VasuAgrawal/BedPresence/PCB/main_board/main_board.kicad_pcb

## KiCad design PCB/main_board/main_board.kicad_pcb (2021-10-16)

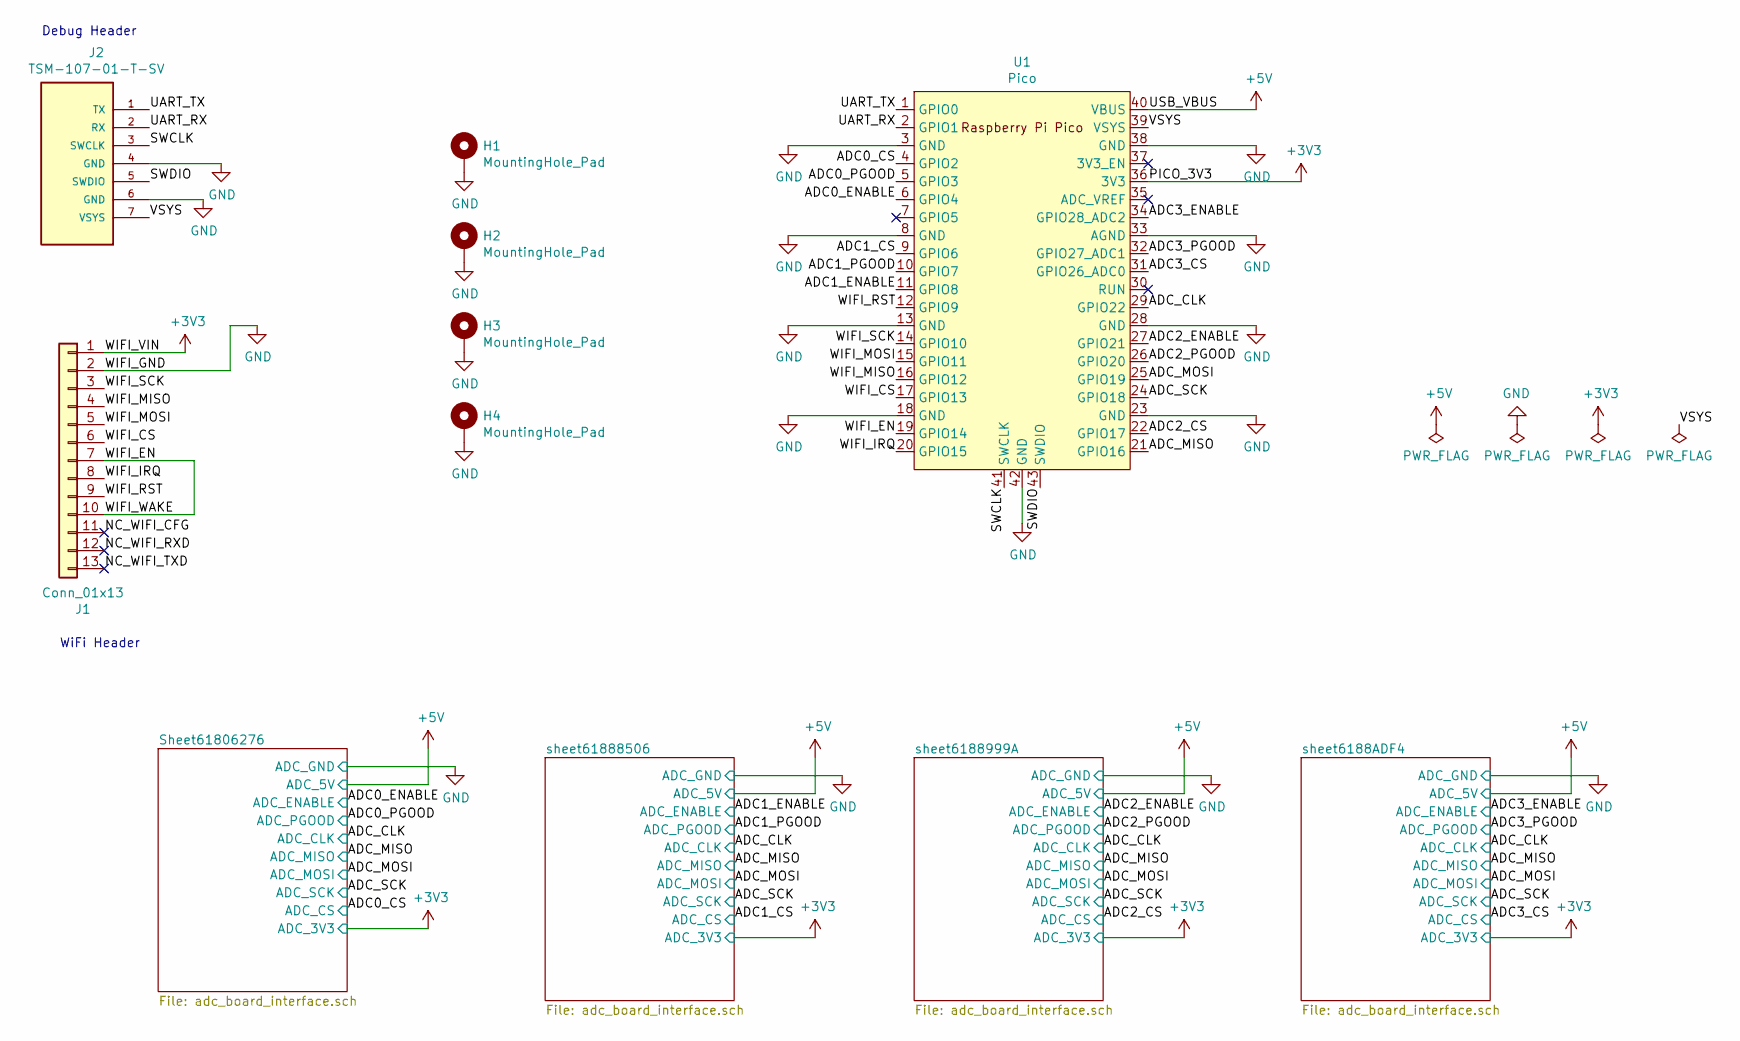
[picture p1: schematic main_board.sch]

Parts:
H1, H2, H3, H4: MountingHole_Pad; MountingHole_3.2mm_M3_Pad_Via
J1: Conn_01x13; PinHeader_1x13_P2.54mm_Vertical_SMD_Pin1Left_with_holes
J2: TSM-107-01-T-SV; SAMTEC_TSM-107-01-T-SV
U1: Pico; RPi_Pico_SMD

Connections:
+3V3: J1.1, U1.36 (3V3); also elsewhere on the board
+5V: U1.40 (VBUS); also elsewhere on the board
/ADC0_CS: U1.4 (GPIO2); also elsewhere on the board
/ADC0_ENABLE: U1.6 (GPIO4); also elsewhere on the board
/ADC0_PGOOD: U1.5 (GPIO3); also elsewhere on the board
/ADC1_CS: U1.9 (GPIO6); also elsewhere on the board
/ADC1_ENABLE: U1.11 (GPIO8); also elsewhere on the board
/ADC1_PGOOD: U1.10 (GPIO7); also elsewhere on the board
/ADC2_CS: U1.22 (GPIO17); also elsewhere on the board
/ADC2_ENABLE: U1.27 (GPIO21); also elsewhere on the board
/ADC2_PGOOD: U1.26 (GPIO20); also elsewhere on the board
/ADC3_CS: U1.31 (GPIO26_ADC0); also elsewhere on the board
/ADC3_ENABLE: U1.34 (GPIO28_ADC2); also elsewhere on the board
/ADC3_PGOOD: U1.32 (GPIO27_ADC1); also elsewhere on the board
/ADC_CLK: U1.29 (GPIO22); also elsewhere on the board
/ADC_MISO: U1.21 (GPIO16); also elsewhere on the board
/ADC_MOSI: U1.25 (GPIO19); also elsewhere on the board
/ADC_SCK: U1.24 (GPIO18); also elsewhere on the board
/NC_WIFI_CFG: J1.11
/NC_WIFI_RXD: J1.12
/NC_WIFI_TXD: J1.13
/SWCLK: J2.3 (SWCLK), U1.41 (SWCLK)
/SWDIO: J2.5 (SWDIO), U1.43 (SWDIO)
/UART_RX: J2.2 (RX), U1.2 (GPIO1)
/UART_TX: J2.1 (TX), U1.1 (GPIO0)
/VSYS: J2.7 (VSYS), U1.39 (VSYS)
/WIFI_CS: J1.6, U1.17 (GPIO13)
/WIFI_EN: J1.7, J1.10, U1.19 (GPIO14)
/WIFI_IRQ: J1.8, U1.20 (GPIO15)
/WIFI_MISO: J1.4, U1.16 (GPIO12)
/WIFI_MOSI: J1.5, U1.15 (GPIO11)
/WIFI_RST: J1.9, U1.12 (GPIO9)
/WIFI_SCK: J1.3, U1.14 (GPIO10)
GND: H1.1, H2.1, H3.1, H4.1, J1.2, J2.4 (GND), J2.6 (GND), U1.3 (GND), U1.8 (GND), U1.13 (GND), U1.18 (GND), U1.23 (GND), U1.28 (GND), U1.33 (AGND), U1.38 (GND), U1.42 (GND); also elsewhere on the board

Notes on the sheet:
WiFi Header
Debug Header

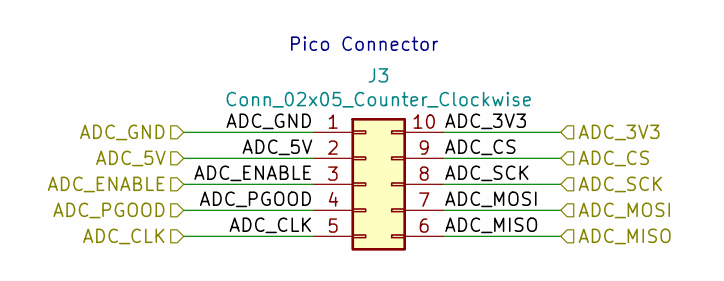
[picture p2: schematic adc_board_interface.sch]

Parts:
J3: Conn_02x05_Counter_Clockwise; PinHeader_2x05_P2.54mm_Vertical_SMD

Connections:
+3V3: J3.10; also elsewhere on the board
+5V: J3.2; also elsewhere on the board
/ADC0_CS: J3.9; also elsewhere on the board
/ADC0_ENABLE: J3.3; also elsewhere on the board
/ADC0_PGOOD: J3.4; also elsewhere on the board
/ADC_CLK: J3.5; also elsewhere on the board
/ADC_MISO: J3.6; also elsewhere on the board
/ADC_MOSI: J3.7; also elsewhere on the board
/ADC_SCK: J3.8; also elsewhere on the board
GND: J3.1; also elsewhere on the board

Parts of its further copies:
J4, J5, J6: Conn_02x05_Counter_Clockwise; PinHeader_2x05_P2.54mm_Vertical_SMD

Connections of its further copies:
+3V3: J4.10, J5.10, J6.10; also elsewhere on the board
+5V: J4.2, J5.2, J6.2; also elsewhere on the board
/ADC1_CS: J4.9; also elsewhere on the board
/ADC1_ENABLE: J4.3; also elsewhere on the board
/ADC1_PGOOD: J4.4; also elsewhere on the board
/ADC2_CS: J5.9; also elsewhere on the board
/ADC2_ENABLE: J5.3; also elsewhere on the board
/ADC2_PGOOD: J5.4; also elsewhere on the board
/ADC3_CS: J6.9; also elsewhere on the board
/ADC3_ENABLE: J6.3; also elsewhere on the board
/ADC3_PGOOD: J6.4; also elsewhere on the board
/ADC_CLK: J4.5, J5.5, J6.5; also elsewhere on the board
/ADC_MISO: J4.6, J5.6, J6.6; also elsewhere on the board
/ADC_MOSI: J4.7, J5.7, J6.7; also elsewhere on the board
/ADC_SCK: J4.8, J5.8, J6.8; also elsewhere on the board
GND: J4.1, J5.1, J6.1; also elsewhere on the board

Notes on the sheet:
Pico Connector

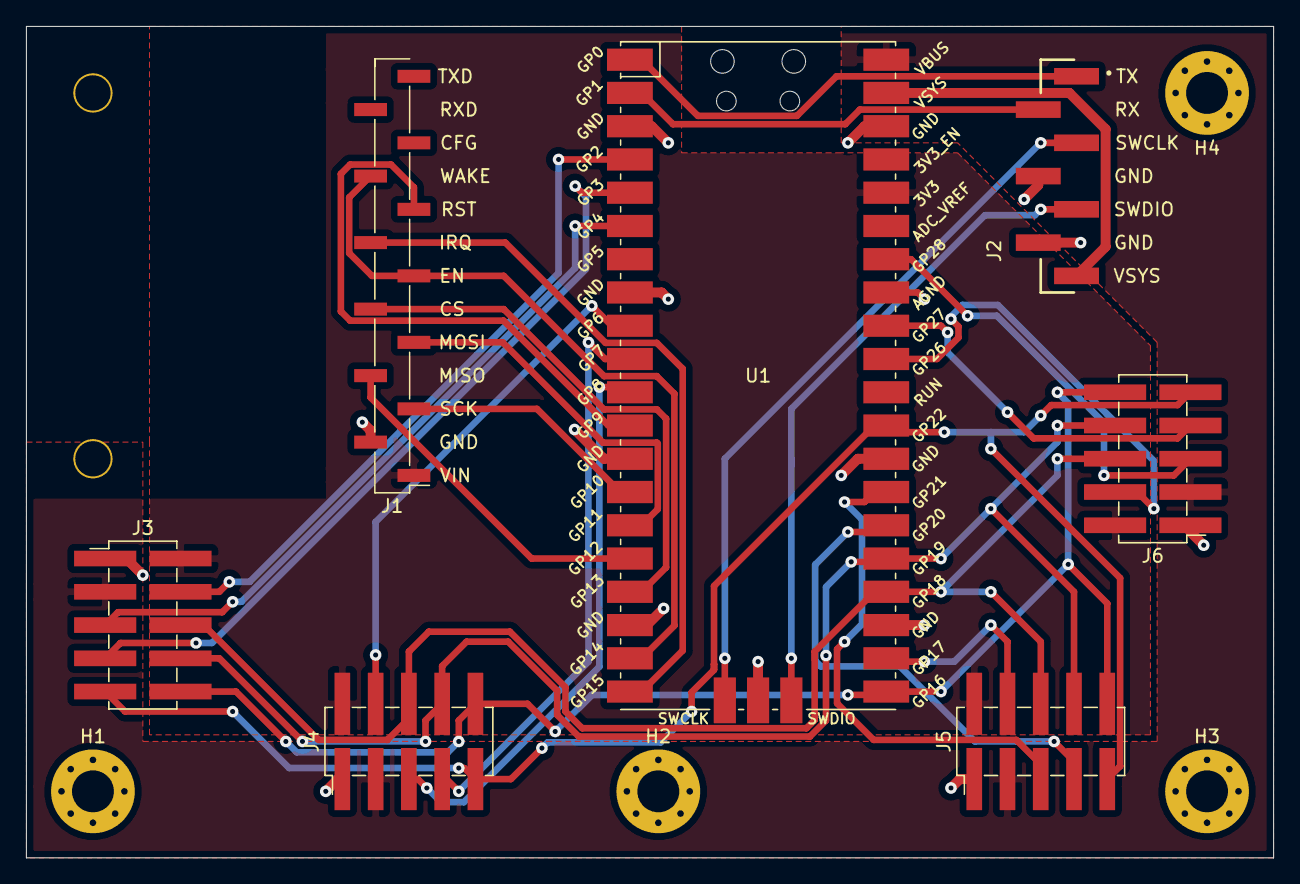
[picture p3: board main_board.kicad_pcb from above]

Board: 2 copper layers, 95.2 x 63.5 mm, 11 parts (0 on the bottom side), 31 nets.
