VasuAgrawal/BedPresence/PCB/pico_probe/pico_probe.kicad_pcb

## KiCad design PCB/pico_probe/pico_probe.kicad_pcb (2021-10-11)

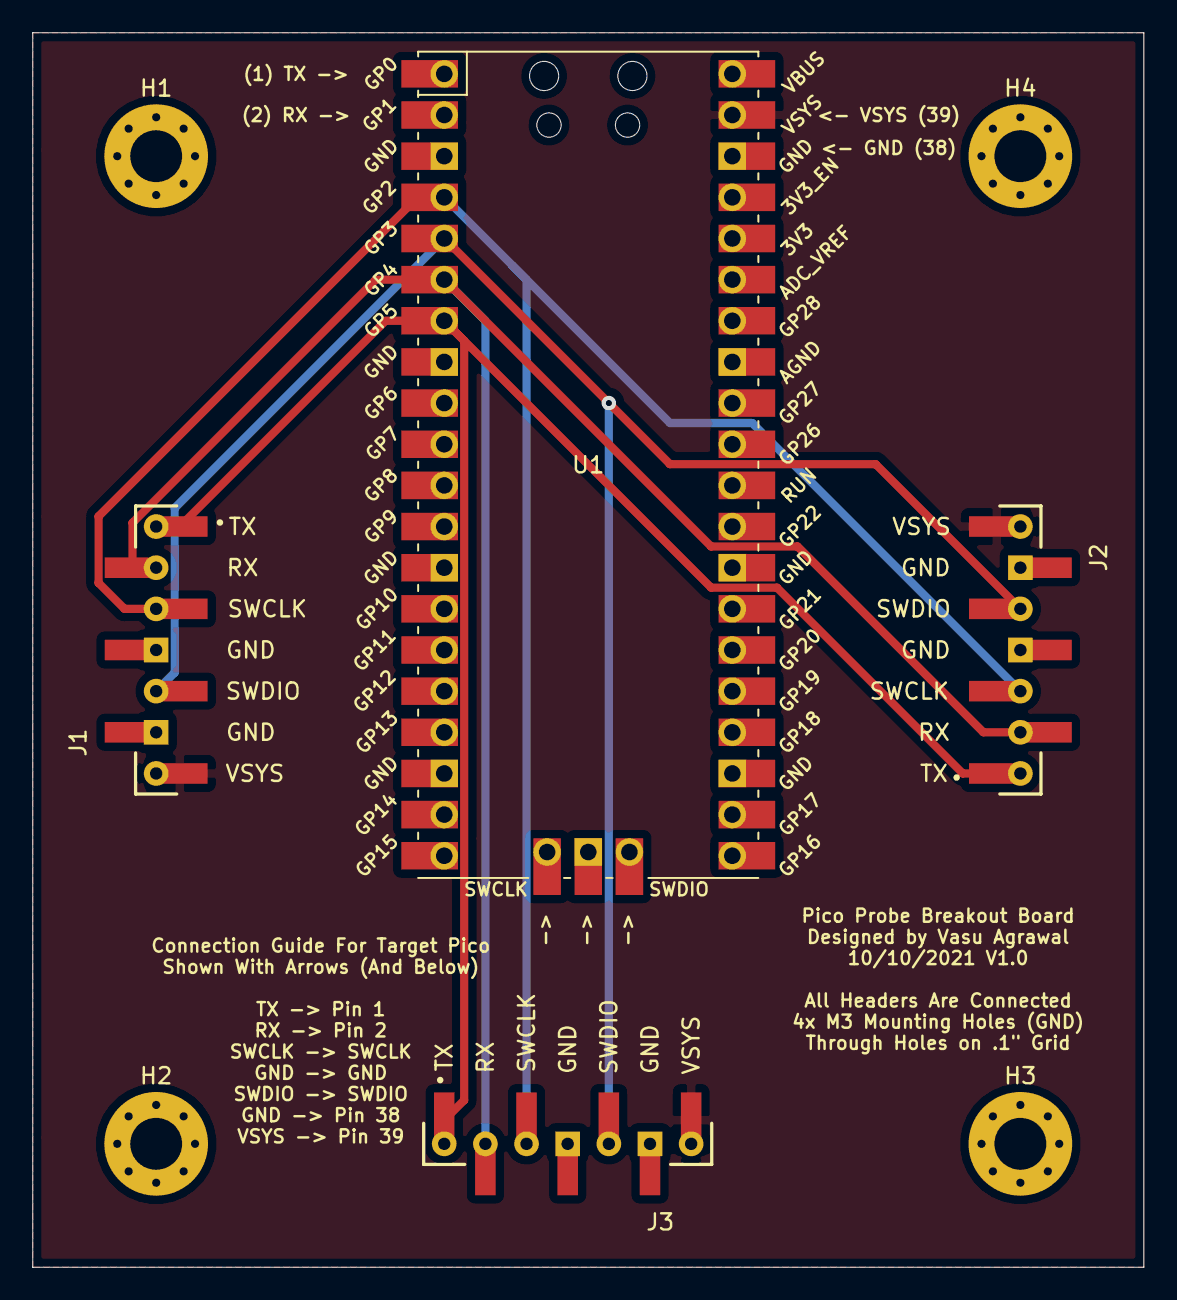
[picture p4: board pico_probe.kicad_pcb from above]

Board: 2 copper layers, 68.6 x 76.2 mm, 8 parts (0 on the bottom side), 6 nets.

Parts:
H1, H2, H3, H4: MountingHole_Pad; MountingHole_3.2mm_M3_Pad_Via
J1, J2, J3: TSM-107-01-T-SV; SAMTEC_TSM-107-01-T-SV_THRU
U1: Pico; RPi_Pico_SMD_TH

Connections:
/PROBE_UART1_RX: J1.1, J2.1, J3.1, U1.7
/PROBE_UART1_TX: J1.2, J2.2, J3.2, U1.6
/SWCLK: J1.3, J2.3, J3.3, U1.4
/SWDIO: J1.5, J2.5, J3.5, U1.5
/VSYS: J1.7, J2.7, J3.7, U1.39
GND: H1.1, H2.1, H3.1, H4.1, J1.4, J1.6, J2.4, J2.6, J3.4, J3.6, U1.3, U1.8, U1.13, U1.18, U1.23, U1.28, U1.33, U1.38, U1.42
