VasuAgrawal/BedPresence/PCB/adc_board/adc_board.kicad_pcb

## KiCad design PCB/adc_board/adc_board.kicad_pcb (2021-10-10)

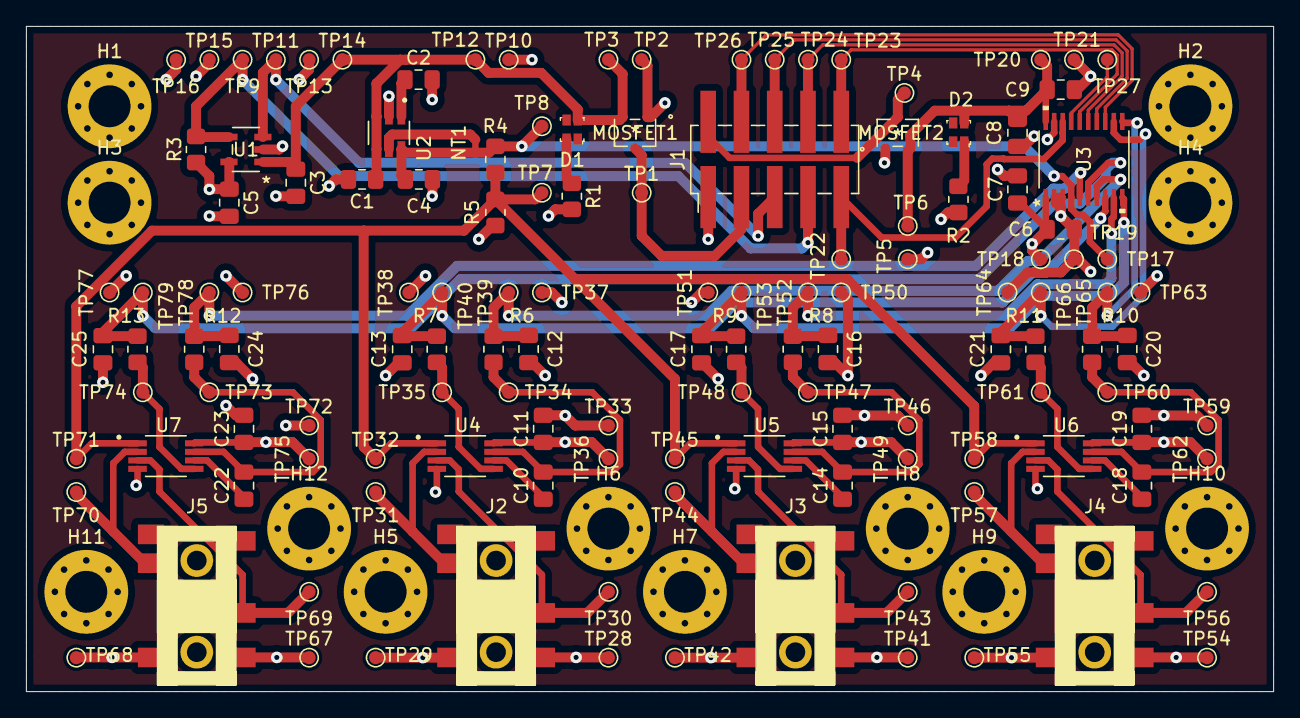
[picture p5: board adc_board.kicad_pcb from above]

Board: 4 copper layers, 95.2 x 50.8 mm, 146 parts (0 on the bottom side), 48 nets.

Parts:
C1, C2, C4, C6, C9, C11, C12, C13, C15, C16, C17, C19, C20, C21, C23, C24, C25: 0.1uF; C_0805_2012Metric_Pad1.18x1.45mm_HandSolder
C3, C5, C7, C8: 10uF; C_0805_2012Metric_Pad1.18x1.45mm_HandSolder
C10, C14, C18, C22: 10nF; C_0805_2012Metric_Pad1.18x1.45mm_HandSolder
D1, D2: LTST-C19HE1WT; LED_Dual0603
H1, H2, H3, H4, H5, H6, H7, H8, H9, H10, H11, H12: MountingHole; MountingHole_3.2mm_M3_Pad_Via
J1: Conn_02x05_Counter_Clockwise; PinHeader_2x05_P2.54mm_Vertical_SMD
J2, J3, J4, J5: 54-00177
MOSFET1, MOSFET2: SSM3J332R
NT1: Net-Tie_2; NetTie-2_SMD_Pad0.5mm
R1, R2, R6, R7, R8, R9, R10, R11, R12, R13: 100R; R_0805_2012Metric_Pad1.20x1.40mm_HandSolder
R3, R4, R5: 10K 0.5%; R_0805_2012Metric_Pad1.20x1.40mm_HandSolder
TP1, TP4: 3V3; TestPoint_Pad_D1.0mm
TP2, TP5, TP10, TP13, TP16, TP19, TP21, TP29, TP33, TP37, TP38, TP42, TP46, TP50, TP51, TP55, TP59, TP63, TP64, TP68, TP72, TP76, TP77: GND; TestPoint_Pad_D1.0mm
TP3, TP12, TP14: 5V_PROT; TestPoint_Pad_D1.0mm
TP6: 3V3_PROT; TestPoint_Pad_D1.0mm
TP7: 1V65_REF; TestPoint_Pad_D1.0mm
TP8, TP17: 3V3_REF; TestPoint_Pad_D1.0mm
TP9: PGOOD; TestPoint_Pad_D1.0mm
TP11: ENABLE; TestPoint_Pad_D1.0mm
TP15, TP18: AVDD; TestPoint_Pad_D1.0mm
TP20: DVDD; TestPoint_Pad_D1.0mm
TP22: CLK; TestPoint_Pad_D1.0mm
TP23: MISO; TestPoint_Pad_D1.0mm
TP24: MOSI; TestPoint_Pad_D1.0mm
TP25: SCK; TestPoint_Pad_D1.0mm
TP26: CS; TestPoint_Pad_D1.0mm
TP27: IRQ; TestPoint_Pad_D1.0mm
TP28, TP36, TP41, TP49, TP54, TP62, TP67, TP75: VDD; TestPoint_Pad_D1.0mm
TP30, TP43, TP56, TP69: BR+; TestPoint_Pad_D1.0mm
TP31, TP44, TP57, TP70: BR-; TestPoint_Pad_D1.0mm
TP32, TP45, TP58, TP71: 1V65; TestPoint_Pad_D1.0mm
TP34, TP47, TP60, TP73: AMP+; TestPoint_Pad_D1.0mm
TP35, TP48, TP61, TP74: AMP-; TestPoint_Pad_D1.0mm
TP39, TP52, TP65, TP78: DIFF+; TestPoint_Pad_D1.0mm
TP40, TP53, TP66, TP79: DIFF-; TestPoint_Pad_D1.0mm
U1: MCP1755T-3302E_OT; MCP1755T-3302E&slash_OT
U2: MAX6070BAUT33T; SOT95P280X145-6N
U3: MCP3564-E_ST; MCP3564-E&slash_ST
U4, U5, U6, U7: MAX4209HAUA; SOP65P490X110-8N

Connections:
+3V3: J1.10, MOSFET2.3, TP4.1
+5V: J1.2, MOSFET1.3, TP1.1
/1V65_REF: R4.2, R5.1, TP7.1, TP32.1, TP45.1, TP58.1, TP71.1, U4.1, U5.1, U6.1, U7.1
/3V3_PROT: C8.1, C9.1, D2.4, MOSFET2.2, TP6.1, TP20.1, U3.20
/3V3_REF_FILTER: C2.1, U2.1
/3V3_REF_OUT: C4.1, NT1.2, R4.1, TP8.1, TP17.1, U2.6, U3.4
/3V3_REF_OUTS: NT1.1, U2.5
/3V3_REF_VIN: C1.1, C3.1, D1.4, MOSFET1.2, TP3.1, TP12.1, TP14.1, U1.1, U2.3, U2.4
/ADC_AVDD: C5.1, C6.1, C7.1, C11.1, C15.1, C19.1, C23.1, J2.1, J3.1, J4.1, J5.1, R3.1, TP15.1, TP18.1, TP28.1, TP36.1, TP41.1, TP49.1, TP54.1, TP62.1, TP67.1, TP75.1, U1.5, U3.1, U4.8, U5.8, U6.8, U7.8
/ADC_CLK: J1.5, TP22.1, U3.18
/ADC_IRQ: TP27.1, U3.17
/CS: J1.9, TP26.1, U3.13
/ENABLE: J1.3, TP11.1, U1.3
/MISO: J1.6, TP23.1, U3.16
/MOSI: J1.7, TP24.1, U3.15
/PGOOD: J1.4, R3.2, TP9.1, U1.4
/SCK: J1.8, TP25.1, U3.14
/Sheet61550FD4/ADC_CH0: C24.1, R12.2, TP78.1, U3.5
/Sheet61550FD4/ADC_CH1: C25.1, R13.2, TP79.1, U3.6
/Sheet61550FD4/ADC_CH2: C12.1, R6.2, TP39.1, U3.7
/Sheet61550FD4/ADC_CH3: C13.1, R7.2, TP40.1, U3.8
/Sheet61550FD4/ADC_CH4: C16.1, R8.2, TP52.1, U3.9
/Sheet61550FD4/ADC_CH5: C17.1, R9.2, TP53.1, U3.10
/Sheet61550FD4/ADC_CH6: C20.1, R10.2, TP65.1, U3.11
/Sheet61550FD4/ADC_CH7: C21.1, R11.2, TP66.1, U3.12
/Sheet61550FD4/Bridge0/BRIDGE+: J5.3, TP69.1, U7.3
/Sheet61550FD4/Bridge0/BRIDGE-: J5.4, TP70.1, U7.2
/Sheet61550FD4/Bridge0/INST_AMP+: C22.1, R12.1, TP73.1, U7.7
/Sheet61550FD4/Bridge0/INST_AMP-: R13.1, TP74.1, U7.5
/Sheet61550FD4/Bridge1/BRIDGE+: J2.3, TP30.1, U4.3
/Sheet61550FD4/Bridge1/BRIDGE-: J2.4, TP31.1, U4.2
/Sheet61550FD4/Bridge1/INST_AMP+: C10.1, R6.1, TP34.1, U4.7
/Sheet61550FD4/Bridge1/INST_AMP-: R7.1, TP35.1, U4.5
/Sheet61550FD4/Bridge2/BRIDGE+: J3.3, TP43.1, U5.3
/Sheet61550FD4/Bridge2/BRIDGE-: J3.4, TP44.1, U5.2
/Sheet61550FD4/Bridge2/INST_AMP+: C14.1, R8.1, TP47.1, U5.7
/Sheet61550FD4/Bridge2/INST_AMP-: R9.1, TP48.1, U5.5
/Sheet61550FD4/Bridge3/BRIDGE+: J4.3, TP56.1, U6.3
/Sheet61550FD4/Bridge3/BRIDGE-: J4.4, TP57.1, U6.2
/Sheet61550FD4/Bridge3/INST_AMP+: C18.1, R10.1, TP60.1, U6.7
/Sheet61550FD4/Bridge3/INST_AMP-: R11.1, TP61.1, U6.5
GND: C1.2, C2.2, C3.2, C4.2, C5.2, C6.2, C7.2, C8.2, C9.2, C11.2, C12.2, C13.2, C15.2, C16.2, C17.2, C19.2, C20.2, C21.2, C23.2, C24.2, C25.2, H1.1, H2.1, H3.1, H4.1, H5.1, H6.1, H7.1, H8.1, H9.1, H10.1, H11.1, H12.1, J1.1, J2.2, J3.2, J4.2, J5.2, MOSFET1.1, MOSFET2.1, R1.2, R2.2, R5.2, TP2.1, TP5.1, TP10.1, TP13.1, TP16.1, TP19.1, TP21.1, TP29.1, TP33.1, TP37.1, TP38.1, TP42.1, TP46.1, TP50.1, TP51.1, TP55.1, TP59.1, TP63.1, TP64.1, TP68.1, TP72.1, TP76.1, TP77.1, U1.2, U2.2, U3.2, U3.3, U3.19, U4.4, U5.4, U6.4, U7.4
unnamed: C10.2, U4.6
unnamed: C14.2, U5.6
unnamed: C18.2, U6.6
unnamed: C22.2, U7.6
unnamed: D1.2, R1.1
unnamed: D2.1, R2.1
