VasuAgrawal/BedPresence/PCB/bridge_board/bridge_board.kicad_pcb

## KiCad design PCB/bridge_board/bridge_board.kicad_pcb (2021-08-31)

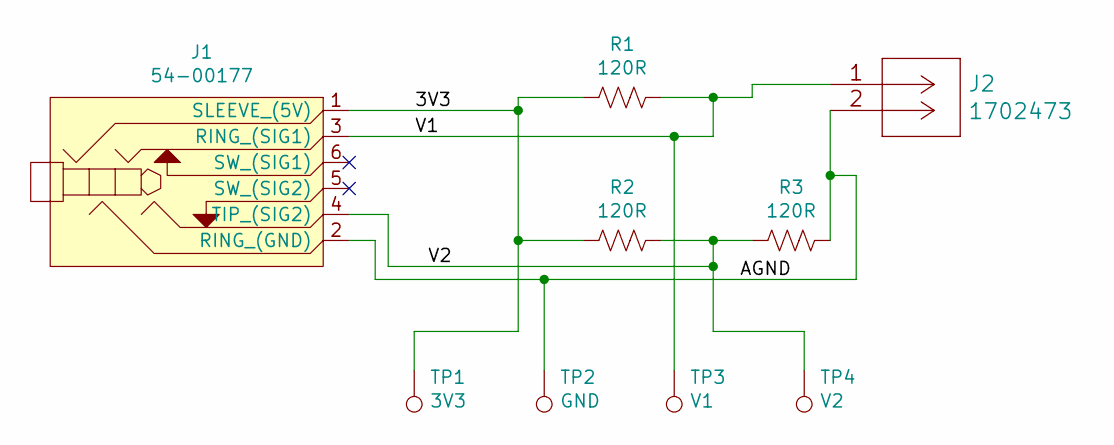
[picture p6: schematic bridge_board.sch]

Parts:
J1: 54-00177
J2: 1702473
R1, R2, R3: 120R; R_0805_2012Metric_Pad1.20x1.40mm_HandSolder
TP1: 3V3; TestPoint_Pad_D1.5mm
TP2: GND; TestPoint_Pad_D1.5mm
TP3: V1; TestPoint_Pad_D1.5mm
TP4: V2; TestPoint_Pad_D1.5mm

Connections:
/3V3: J1.1 (SLEEVE_(5V)), R1.2, R2.1, TP1.1
/AGND: J1.2 (RING_(GND)), J2.2, R3.2, TP2.1
/V1: J1.3 (RING_(SIG1)), J2.1, R1.1, TP3.1
/V2: J1.4 (TIP_(SIG2)), R2.2, R3.1, TP4.1

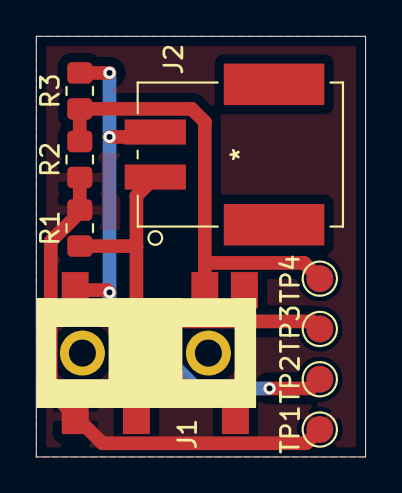
[picture p7: board bridge_board.kicad_pcb from above]

Board: 4 copper layers, 18.3 x 23.4 mm, 9 parts (0 on the bottom side), 4 nets.
