VasuAgrawal/BedPresence/(commit log)

2021-07-05 Read from ADC
    Gave up on interrupts temporarily. For now, we'll just stick to polling
    on the GPIO pin, since the pico doesn't actually have to do anything
    else.
    [ADC.cpp, bit_utils.h, mcp356x.h]
2021-08-05 Determine voltage reading
    I added some code to print out the voltage reading. It looks like the
    voltage isn't quite what I expect it to be - I'm not sure whether this
    is because the voltage reference isn't as stable as I want it to be, or
    because there's noise, or something else. I'm hoping some of the noise
    issues go away when I make a PCB (since I'll have decoupling caps
    everywhere, and the wires won't all be acting as gigantic antennas).
    I've also ordered voltage reference ICs, which can serve double duty as
    the power supply for the instrumentation amplifier I ordered (since I
    wasn't able to get my 3x op amp configuration working as expected,
    probably due to needing to trim the resistors?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
    [ADC.cpp]
2021-08-16 First time putting everything together
    I finally figured out how negative inputs work.
    You can feed two ground-referenced signals to the two inputs, and then
    the ADC will subtract the two and give you the converted difference,
    scaled to the +/- ADC reference value. So, you could have output values
    from the range -V_ref to +V_ref.
    I feed the reference voltage from the amplifier as the Vin_minus, and
    the output voltage from the amplifier as the Vin_plus. This is then
    amplified further (4x) inside the ADC, to give me values around 0V - 1V.
    I also determined what what wires I'm going to send where. In order to
    be compatible with other wheatstone-bridge-type sensors, I'll use a TRRS
    3.5mm cabl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
2021-08-31 Adding bridge_board v1 PCB
    [bridge_board.kicad_pcb, bridge_board.sch]
2021-09-15 Added mostly-complete version of main board
    [adc_with_amps.sch, bridge_interface.sch, main_board.kicad_pcb, main_board.sch]
2021-10-10 ADC board schematic done
    [adc_board.kicad_pcb, adc_board.sch, adc_with_amps.sch, bridge_interface.sch]
2021-10-10 Finished layout for adc board
    [adc_board.kicad_pcb, adc_board.sch, adc_with_amps.sch, bridge_board.sch, bridge_interface.sch]
2021-10-10 reverted mounting hole mistake
    [adc_board.sch, bridge_interface.sch]
2021-10-10 whatever the latest changes were
    [adc_board.kicad_pcb]
2021-10-11 Added pico probe board
    [pico_probe.kicad_pcb, pico_probe.sch]
2021-10-16 Adding gerbers, and updated version of main board
    [adc_board_interface.sch, main_board.kicad_pcb, main_board.sch]
2021-10-16 Add BOM files
    [adc_board.csv, main_board.csv, pico_probe.csv]
2022-02-28 Update ADC code for real board
